alexretana/zmk-config-pseudo-kb/ergogen_build_files/ergogen-2026-06-07/cases/bottom_plate.stl

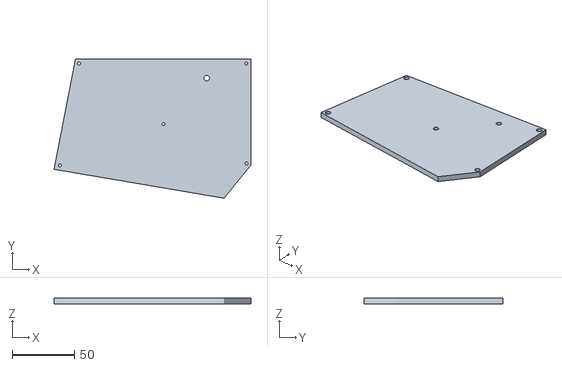
[picture p1: CAD file, 2026-06-07]
ergogen_build_files/ergogen-2026-06-07/cases/bottom_plate.stl
157.8 x 111.7 x 4.50
