alexretana/zmk-config-pseudo-kb/ergogen_build_files/ergogen-2026-06-07/outlines/board_with_holes.dxf

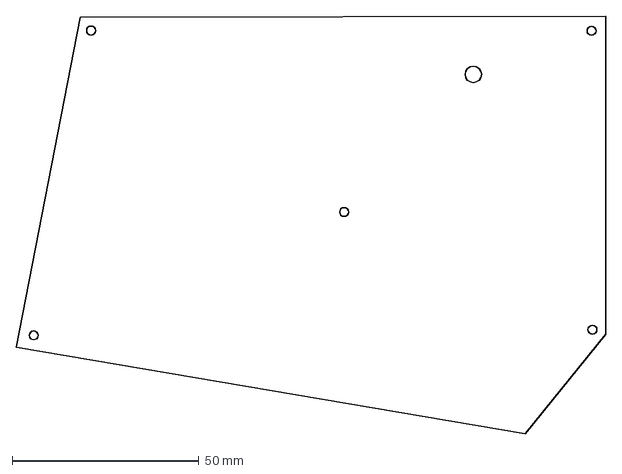
[picture p2: CAD file, 2026-06-07]
ergogen_build_files/ergogen-2026-06-07/outlines/board_with_holes.dxf
157.8 x 111.7 mm
