alexretana/zmk-config-pseudo-kb/ergogen_build_files/ergogen-2026-06-07/cases/switch_plate.stl

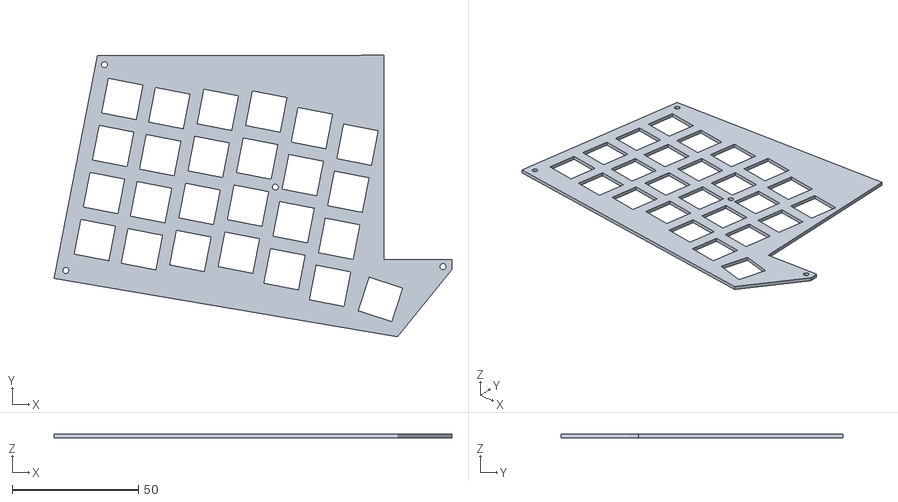
[picture p3: CAD file, 2026-06-07]
ergogen_build_files/ergogen-2026-06-07/cases/switch_plate.stl
157.8 x 111.6 x 1.50
