alexretana/zmk-config-pseudo-kb/ergogen_build_files/ergogen-2026-06-07/outlines/switch_plate.dxf

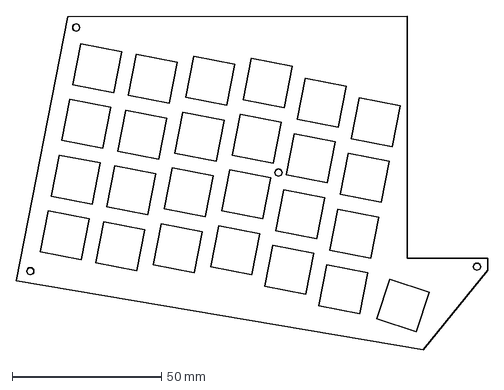
[picture p5: CAD file, 2026-06-07]
ergogen_build_files/ergogen-2026-06-07/outlines/switch_plate.dxf
157.8 x 111.6 mm
