alexretana/zmk-config-pseudo-kb/ergogen_build_files/ergogen-2026-06-07/post_kicad_complete_pcbs/pseudo-kb.kicad_pcb

## KiCad design ergogen_build_files/ergogen-2026-06-07/post_kicad_complete_pcbs/pseudo-kb.kicad_pcb (2026-06-07)

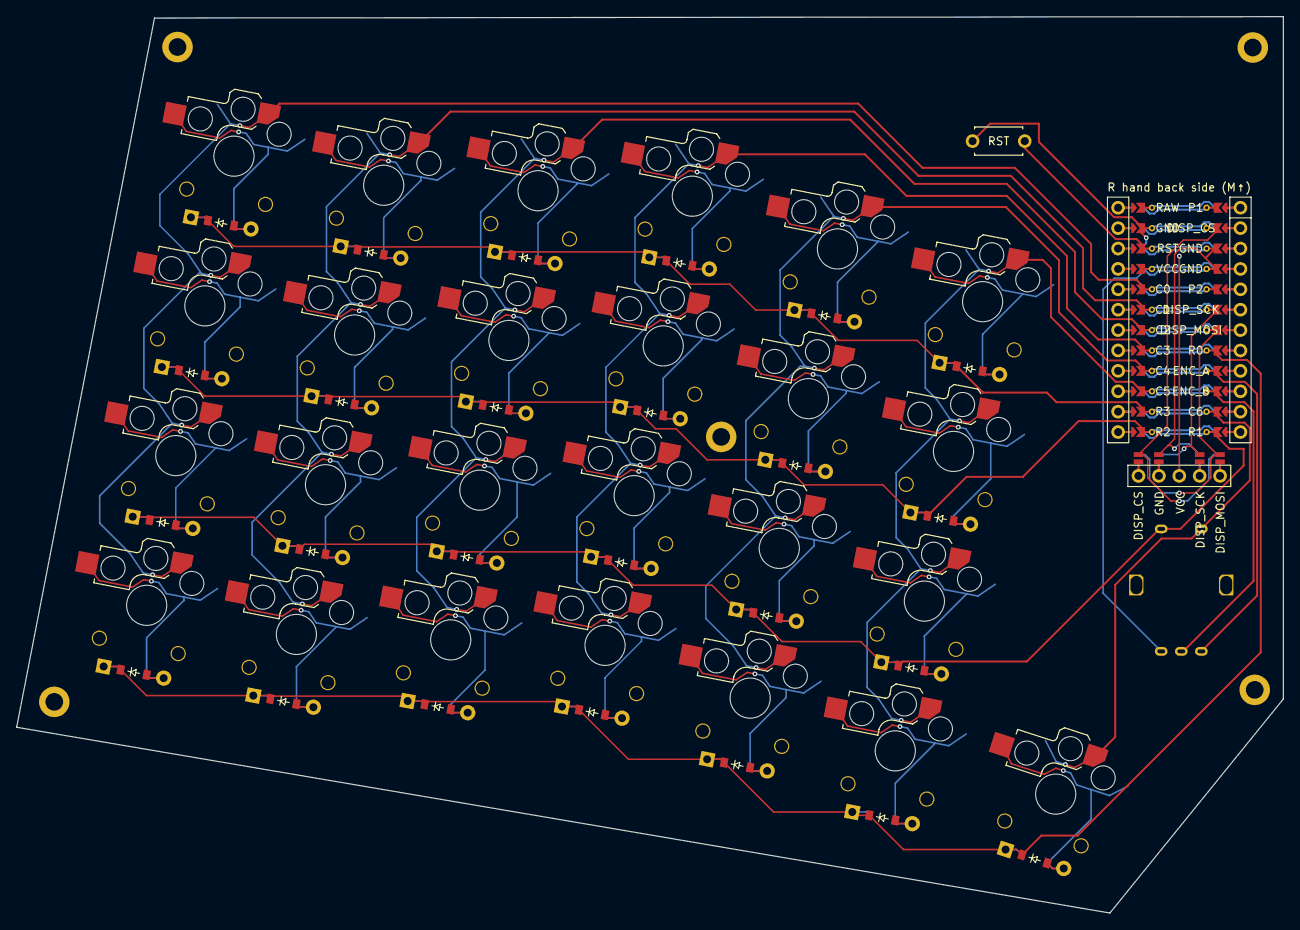
[picture p6: board pseudo-kb.kicad_pcb from above]

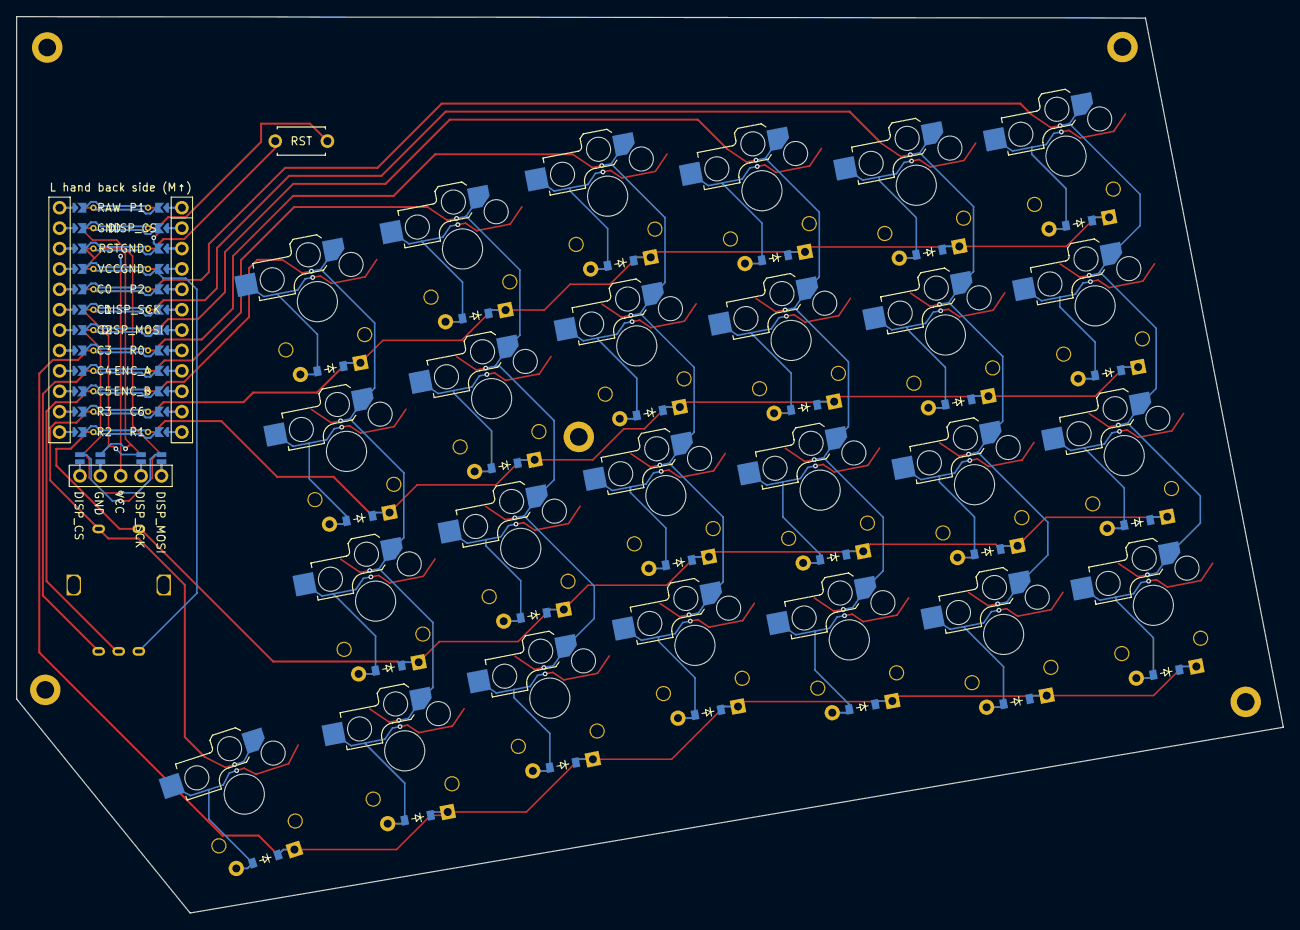
[picture p7: board pseudo-kb.kicad_pcb from below]

Board: 2 copper layers, 157.8 x 111.7 mm, 59 parts (25 on the bottom side), 48 nets.

Parts:
D1, D2, D3, D4, D5, D6, D7, D8, D9, D10, D11, D12, D13, D14, D15, D16, D17, D18, D19, D20, D21, D22, D23, D24, D25: diode_tht_sod123
DISP1: display_nice_view
H1, H2, H3, H4, H5: mounting_hole_plated
MCU1: mcu_nice_nano
RE1: rotary_encoder_ec11_ec12
RST1: reset_switch_tht_top
S1, S2, S3, S4, S5, S6, S7, S8, S9, S10, S11, S12, S13, S14, S15, S16, S17, S18, S19, S20, S21, S22, S23, S24, S25: switch_choc_v1_v2

Connections:
C0: MCU1.120, S1.1, S2.1, S3.1, S4.1
C1: MCU1.119, S5.1, S6.1, S7.1, S8.1
C2: MCU1.118, S9.1, S10.1, S11.1, S12.1
C3: MCU1.117, S13.1, S14.1, S15.1, S16.1
C4: MCU1.116, S17.1, S18.1, S19.1, S20.1
C5: MCU1.115, S21.1, S22.1, S23.1, S24.1
C6: MCU1.111, RE1.S2, S25.1
DISP1_1: DISP1.1, DISP1.10, DISP1.23
DISP1_2: DISP1.2, DISP1.11, DISP1.22
DISP1_4: DISP1.4, DISP1.12, DISP1.21
DISP1_5: DISP1.5, DISP1.13, DISP1.20
DISP_CS: DISP1.14, DISP1.24, MCU1.102
DISP_MOSI: DISP1.17, DISP1.27, MCU1.107
DISP_SCK: DISP1.16, DISP1.26, MCU1.106
ENC_A: MCU1.109, RE1.A
ENC_B: MCU1.110, RE1.B
GND: DISP1.15, DISP1.25, MCU1.103, MCU1.104, MCU1.123, RE1.C, RST1.2
R0: D1.1, D5.1, D9.1, D13.1, D17.1, D24.1, D25.1, MCU1.108
R1: D2.1, D6.1, D10.1, D14.1, D18.1, D21.1, MCU1.112, RE1.S1
R2: D3.1, D7.1, D11.1, D15.1, D19.1, D22.1, MCU1.113
R3: D4.1, D8.1, D12.1, D16.1, D20.1, D23.1, MCU1.114
RST: MCU1.122, RST1.1
VCC: DISP1.3, MCU1.121
far_lower: D25.2, S25.2
home_lower: D24.2, S24.2
index_bottom: D18.2, S18.2
index_home: D19.2, S19.2
index_top: D20.2, S20.2
index_utils: D17.2, S17.2
inner_bottom: D21.2, S21.2
inner_home: D22.2, S22.2
inner_top: D23.2, S23.2
middle_bottom: D14.2, S14.2
middle_home: D15.2, S15.2
middle_top: D16.2, S16.2
middle_utils: D13.2, S13.2
outer_bottom: D2.2, S2.2
outer_home: D3.2, S3.2
outer_top: D4.2, S4.2
outer_utils: D1.2, S1.2
pinky_bottom: D6.2, S6.2
pinky_home: D7.2, S7.2
pinky_top: D8.2, S8.2
pinky_utils: D5.2, S5.2
ring_bottom: D10.2, S10.2
ring_home: D11.2, S11.2
ring_top: D12.2, S12.2
ring_utils: D9.2, S9.2
